VIP-LES/leos-sensor-pcb/LEOS-sensor.kicad_pcb

## KiCad design LEOS-sensor.kicad_pcb (2026-02-17)

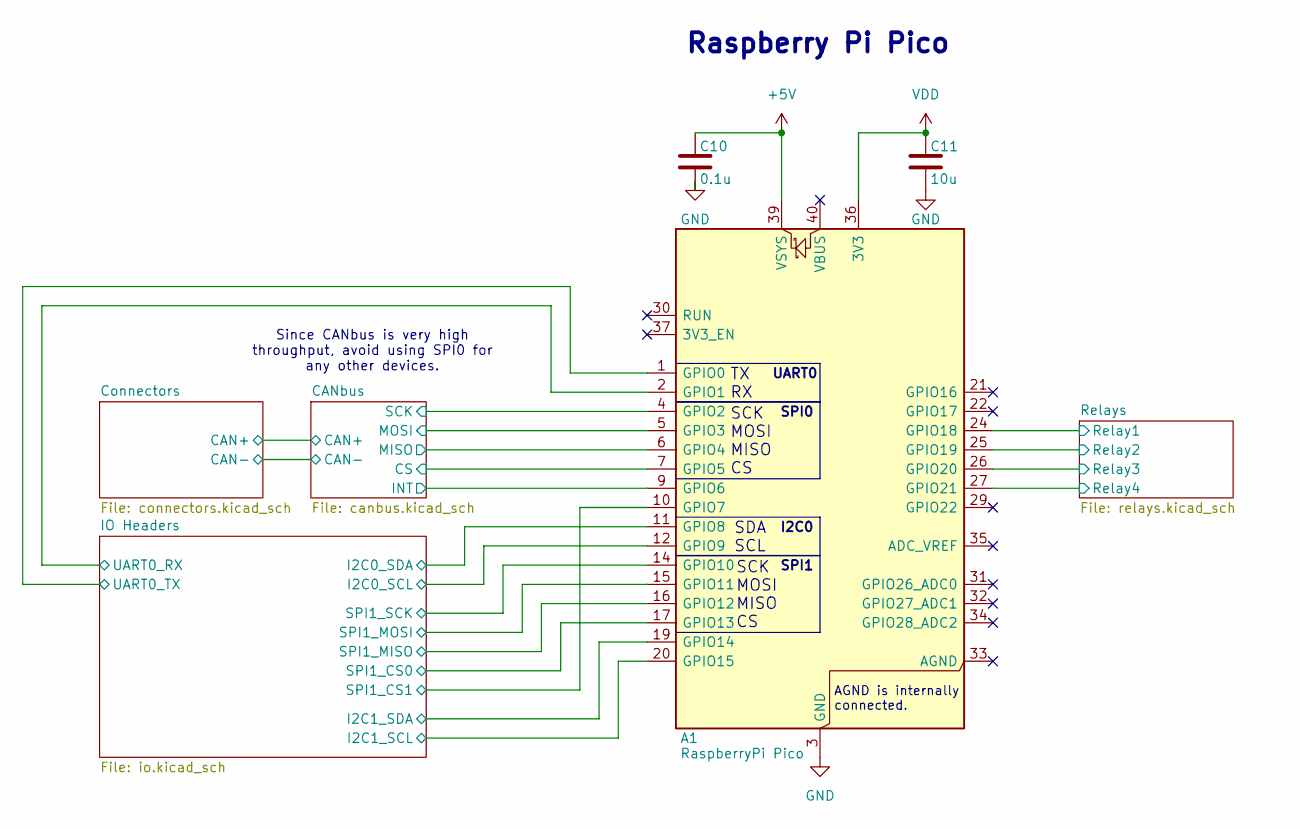
[picture p1: schematic LEOS-sensor.kicad_sch, LEOS Sensor Module]

Parts:
A1: RaspberryPi Pico; RaspberryPi_Pico_Common_THT; MPN PIM724; Digikey 1778-PIM724-ND
C10: 0.1u; C_0603_1608Metric; MPN CL10B104KB8NNNL; Digikey 1276-CL10B104KB8NNNLCT-ND
C11: 10u; C_0805_2012Metric; MPN CL21B106KOQNNNE; Digikey 1276-2872-1-ND

Connections:
+5V: A1.39 (VSYS), C10.1; also elsewhere on the board
/CANbus/CS: A1.7 (GPIO5); also elsewhere on the board
/CANbus/INT: A1.9 (GPIO6); also elsewhere on the board
/CANbus/MISO: A1.6 (GPIO4); also elsewhere on the board
/CANbus/MOSI: A1.5 (GPIO3); also elsewhere on the board
/CANbus/SCK: A1.4 (GPIO2); also elsewhere on the board
/IO Headers/I2C0_SCL: A1.12 (GPIO9); also elsewhere on the board
/IO Headers/I2C0_SDA: A1.11 (GPIO8); also elsewhere on the board
/IO Headers/I2C1_SCL: A1.20 (GPIO15); also elsewhere on the board
/IO Headers/I2C1_SDA: A1.19 (GPIO14); also elsewhere on the board
/IO Headers/SPI1_CS0: A1.17 (GPIO13); also elsewhere on the board
/IO Headers/SPI1_CS1: A1.10 (GPIO7); also elsewhere on the board
/IO Headers/SPI1_MISO: A1.16 (GPIO12); also elsewhere on the board
/IO Headers/SPI1_MOSI: A1.15 (GPIO11); also elsewhere on the board
/IO Headers/SPI1_SCK: A1.14 (GPIO10); also elsewhere on the board
/IO Headers/UART0_RX: A1.2 (GPIO1); also elsewhere on the board
/IO Headers/UART0_TX: A1.1 (GPIO0); also elsewhere on the board
/Relays/Relay1: A1.24 (GPIO18); also elsewhere on the board
/Relays/Relay2: A1.25 (GPIO19); also elsewhere on the board
/Relays/Relay3: A1.26 (GPIO20); also elsewhere on the board
/Relays/Relay4: A1.27 (GPIO21); also elsewhere on the board
GND: A1.3 (GND), A1.8 (GND), A1.13 (GND), A1.18 (GND), A1.23 (GND), A1.28 (GND), A1.38 (GND), C10.2, C11.2; also elsewhere on the board
VDD: A1.36 (3V3), C11.1; also elsewhere on the board

Notes on the sheet:
SPI1
Raspberry Pi Pico
SCK MOSI MISO CS
Since CANbus is very high throughput, avoid using SPI0 for any other devices.
SPI0
SDA SCL
TX RX
UART0
I2C0
AGND is internally connected.

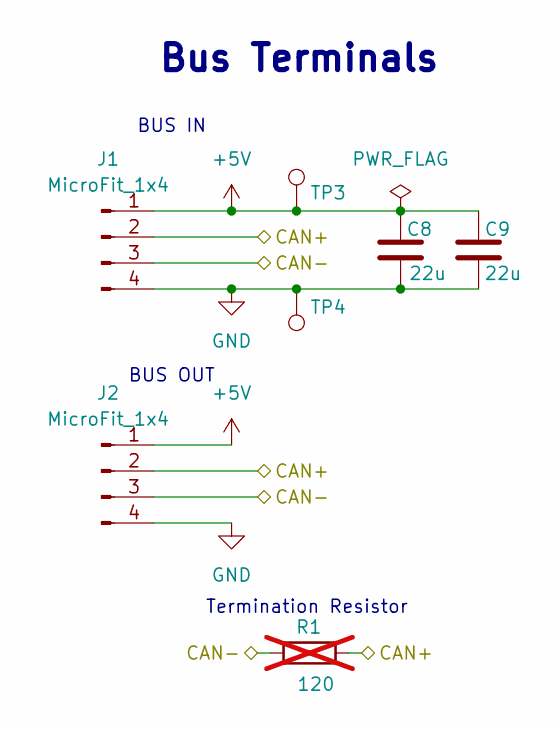
[picture p2: schematic connectors.kicad_sch, LEOS Connectors]

Parts:
C8, C9: 22u; C_0805_2012Metric; MPN CL21A226MAYNNNE; Digikey 1276-CL21A226MAYNNNECT-ND
J1, J2: MicroFit_1x4; Molex_MicroFit3.0_43650-0410_1x04_Horizontal; MPN 0436500409; Digikey WM1882CT-ND
R1: 120; R_Axial_DIN0207_L6.3mm_D2.5mm_P7.62mm_Horizontal; MPN CF14JT120R; Digikey CF14JT120RCT-ND; not fitted
TP3: 5V Test Point; TestPoint_Loop_D2.60mm_Drill0.9mm_Beaded; MPN 5000; Digikey 36-5000-ND
TP4: GND Test Point; TestPoint_Loop_D2.60mm_Drill0.9mm_Beaded; MPN 5001; Digikey 36-5001-ND

Connections:
+5V: C8.1, C9.1, J1.1, J2.1, TP3.1; also elsewhere on the board
/CANbus/CAN+: J1.2, J2.2, R1.2; also elsewhere on the board
/CANbus/CAN-: J1.3, J2.3, R1.1; also elsewhere on the board
GND: C8.2, C9.2, J1.4, J2.4, TP4.1; also elsewhere on the board

Notes on the sheet:
BUS OUT
Bus Terminals
BUS IN
Termination Resistor

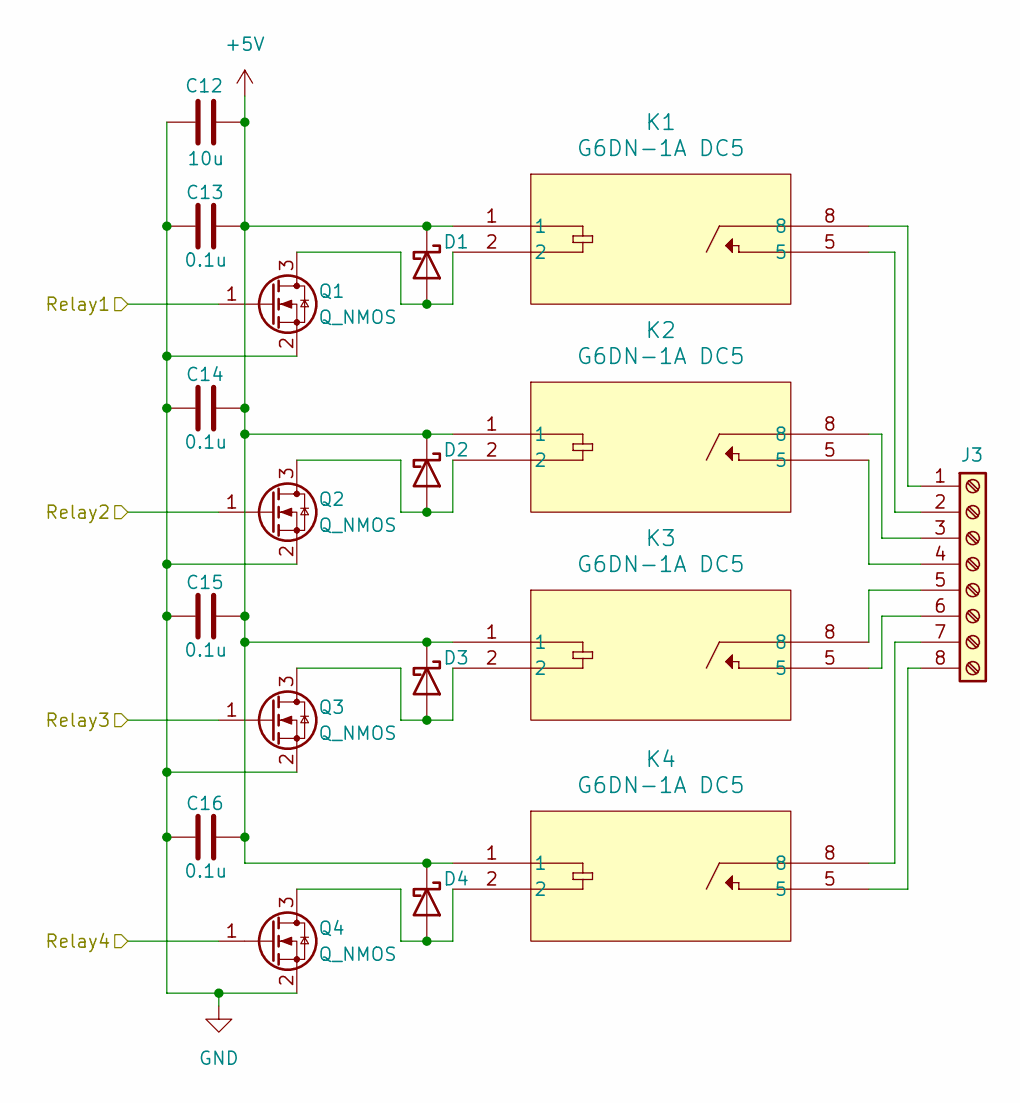
[picture p3: schematic relays.kicad_sch]

Parts:
C12: 10u; C_0805_2012Metric; MPN CL21B106KOQNNNE; LCSC C95841
C13, C14, C15, C16: 0.1u; C_0603_1608Metric; MPN CL10B104KB8NNNL; LCSC C913912
D1, D2, D3, D4: D_Schottky; D_SMA; MPN SS14; LCSC C83852
J3: Screw_Terminal_01x08; TerminalBlock_Phoenix_MKDS-1,5-8-5.08_1x08_P5.08mm_Horizont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; MPN 1715789; Digikey 277-1266-ND
K1, K2, K3, K4: G6DN-1A DC5; RELAY_G6DN-1A_OMR; MPN G6DN-1A DC5; Digikey 39-G6DN-1ADC5-ND
Q1, Q2, Q3, Q4: Q_NMOS; SOT-23; MPN IRLML0030TRPBF; LCSC C67272

Connections:
+5V: C12.2, C13.1, C14.1, C15.1, C16.1, D1.1 (K), D2.1 (K), D3.1 (K), D4.1 (K), K1.1, K2.1, K3.1, K4.1; also elsewhere on the board
/Relays/Relay1: Q1.1 (G); also elsewhere on the board
/Relays/Relay2: Q2.1 (G); also elsewhere on the board
/Relays/Relay3: Q3.1 (G); also elsewhere on the board
/Relays/Relay4: Q4.1 (G); also elsewhere on the board
GND: C12.1, C13.2, C14.2, C15.2, C16.2, Q1.2 (S), Q2.2 (S), Q3.2 (S), Q4.2 (S); also elsewhere on the board
unnamed: D1.2 (A), K1.2, Q1.3 (D)
unnamed: D2.2 (A), K2.2, Q2.3 (D)
unnamed: D3.2 (A), K3.2, Q3.3 (D)
unnamed: D4.2 (A), K4.2, Q4.3 (D)
unnamed: J3.1, K1.8
unnamed: J3.2, K1.5
unnamed: J3.3, K2.8
unnamed: J3.4, K2.5
unnamed: J3.5, K3.8
unnamed: J3.6, K3.5
unnamed: J3.7, K4.8
unnamed: J3.8, K4.5

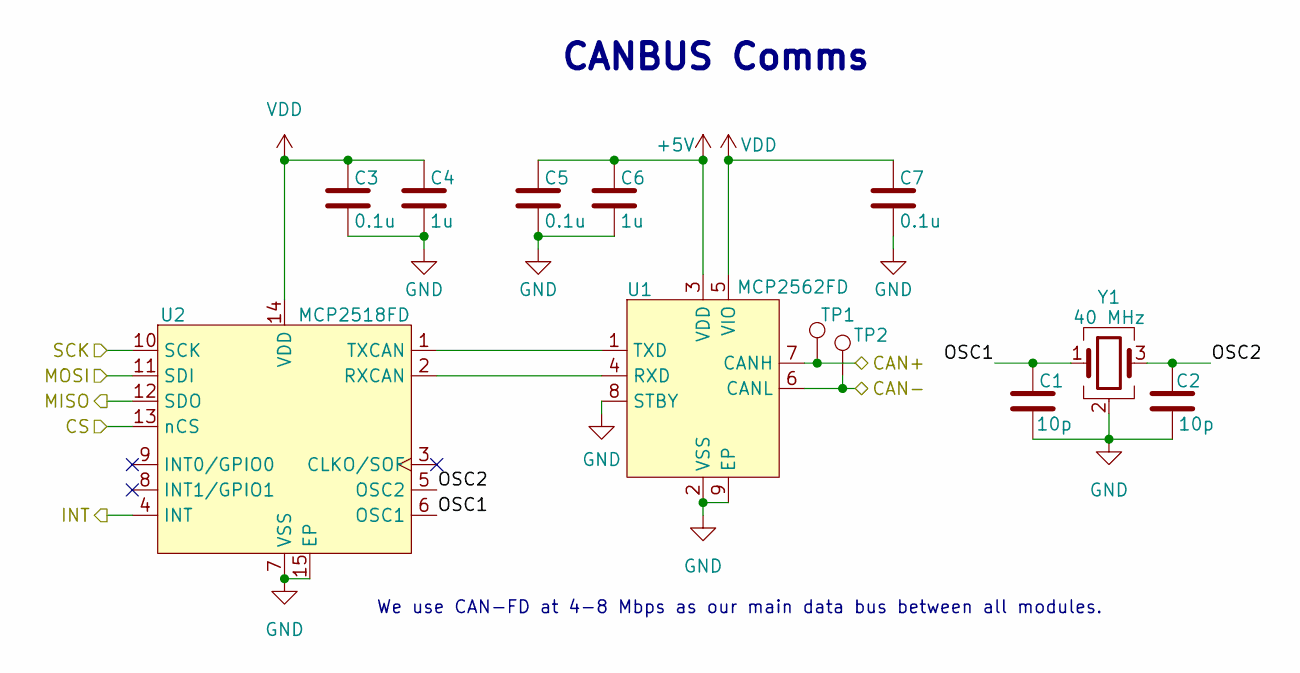
[picture p4: schematic canbus.kicad_sch, LEOS CANbus]

Parts:
C1, C2: 10p; C_0603_1608Metric; MPN CL10C100JB8NNNC; Digikey 1276-1027-1-ND
C3, C5, C7: 0.1u; C_0603_1608Metric; MPN CL10B104KB8NNNL; Digikey 1276-CL10B104KB8NNNLCT-ND
C4, C6: 1u; C_0603_1608Metric; MPN CL10B105KA8NNNC; Digikey 1276-1184-1-ND
TP1: CAN-H Test Point; TestPoint_Loop_D2.60mm_Drill0.9mm_Beaded; MPN 5004; Digikey 36-5004-ND
TP2: CAN-L Test Point; TestPoint_Loop_D2.60mm_Drill0.9mm_Beaded; MPN 5116; Digikey 36-5116-ND
U1: MCP2562FD; SOIC-8_3.9x4.9mm_P1.27mm; MPN MCP2562FDT-H/SN; LCSC C511335
U2: MCP2518FD; SOIC-14_3.9x8.7mm_P1.27mm; MPN MCP2518FDT-E/SL; LCSC C626758
Y1: 40 MHz; Crystal_SMD_2016-4Pin_2.0x1.6mm; MPN ECS-400-10-37B2-CKY-TR; Digikey 50-ECS-400-10-37B2-CKY-TRCT-ND

Connections:
+5V: C5.1, C6.1, U1.3 (VDD); also elsewhere on the board
/CANbus/CAN+: TP1.1, U1.7 (CANH); also elsewhere on the board
/CANbus/CAN-: TP2.1, U1.6 (CANL); also elsewhere on the board
/CANbus/CS: U2.13 (nCS); also elsewhere on the board
/CANbus/INT: U2.4 (INT); also elsewhere on the board
/CANbus/MISO: U2.12 (SDO); also elsewhere on the board
/CANbus/MOSI: U2.11 (SDI); also elsewhere on the board
/CANbus/OSC1: C1.2, U2.6 (OSC1), Y1.1
/CANbus/OSC2: C2.2, U2.5 (OSC2), Y1.3
/CANbus/SCK: U2.10 (SCK); also elsewhere on the board
GND: C1.1, C2.1, C3.2, C4.2, C5.2, C6.2, C7.2, U1.2 (VSS), U1.8 (STBY), U1.9 (EP), U2.7 (VSS), U2.15 (EP), Y1.2 (G), Y1.4 (G); also elsewhere on the board
unnamed: U1.4 (RXD), U2.2 (RXCAN)
unnamed: U1.1 (TXD), U2.1 (TXCAN)
VDD: C3.1, C4.1, C7.1, U1.5 (VIO), U2.14 (VDD); also elsewhere on the board

Notes on the sheet:
CANBUS Comms
We use CAN-FD at 4-8 Mbps as our main data bus between all modules.

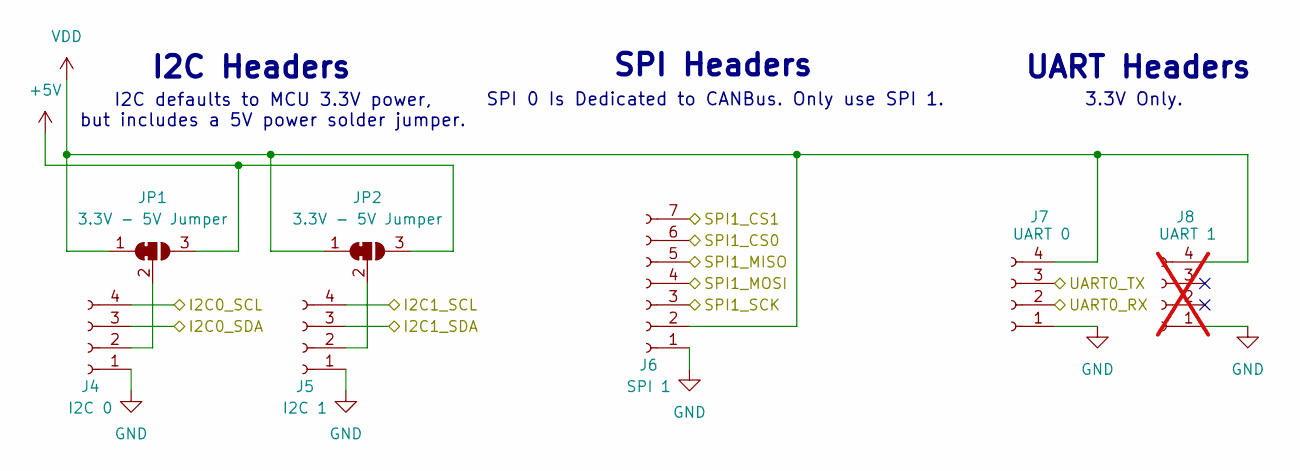
[picture p5: schematic io.kicad_sch, Sensor Board IO Headers]

Parts:
J4: I2C 0; JST_XH_S4B-XH-A_1x04_P2.50mm_Horizontal; MPN S4B-XH-A; Digikey 455-2243-ND
J5: I2C 1; JST_XH_S4B-XH-A_1x04_P2.50mm_Horizontal; MPN S4B-XH-A; Digikey 455-2243-ND
J6: SPI 1; JST_XH_S7B-XH-A_1x07_P2.50mm_Horizontal; MPN S7B-XH-A; Digikey 455-S7B-XH-A-ND
J7: UART 0; JST_XH_S4B-XH-A_1x04_P2.50mm_Horizontal; MPN S4B-XH-A; Digikey 455-2243-ND
J8: UART 1; JST_XH_S4B-XH-A_1x04_P2.50mm_Horizontal; MPN S4B-XH-A; Digikey 455-2243-ND; not fitted
JP1, JP2: 3.3V - 5V Jumper; SolderJumper-3_P1.3mm_Bridged12_RoundedPad1.0x1.5mm

Connections:
+5V: JP1.3 (B), JP2.3 (B); also elsewhere on the board
/IO Headers/I2C0_SCL: J4.4; also elsewhere on the board
/IO Headers/I2C0_SDA: J4.3; also elsewhere on the board
/IO Headers/I2C1_SCL: J5.4; also elsewhere on the board
/IO Headers/I2C1_SDA: J5.3; also elsewhere on the board
/IO Headers/SPI1_CS0: J6.6; also elsewhere on the board
/IO Headers/SPI1_CS1: J6.7; also elsewhere on the board
/IO Headers/SPI1_MISO: J6.5; also elsewhere on the board
/IO Headers/SPI1_MOSI: J6.4; also elsewhere on the board
/IO Headers/SPI1_SCK: J6.3; also elsewhere on the board
/IO Headers/UART0_RX: J7.2; also elsewhere on the board
/IO Headers/UART0_TX: J7.3; also elsewhere on the board
GND: J4.1, J5.1, J6.1, J7.1, J8.1; also elsewhere on the board
unnamed: J4.2, JP1.2 (C)
unnamed: J5.2, JP2.2 (C)
VDD: J6.2, J7.4, J8.4, JP1.1 (A), JP2.1 (A); also elsewhere on the board

Notes on the sheet:
3.3V Only.
SPI Headers
SPI 0 Is Dedicated to CANBus. Only use SPI 1.
UART Headers
I2C defaults to MCU 3.3V power, but includes a 5V power solder jumper.
I2C Headers

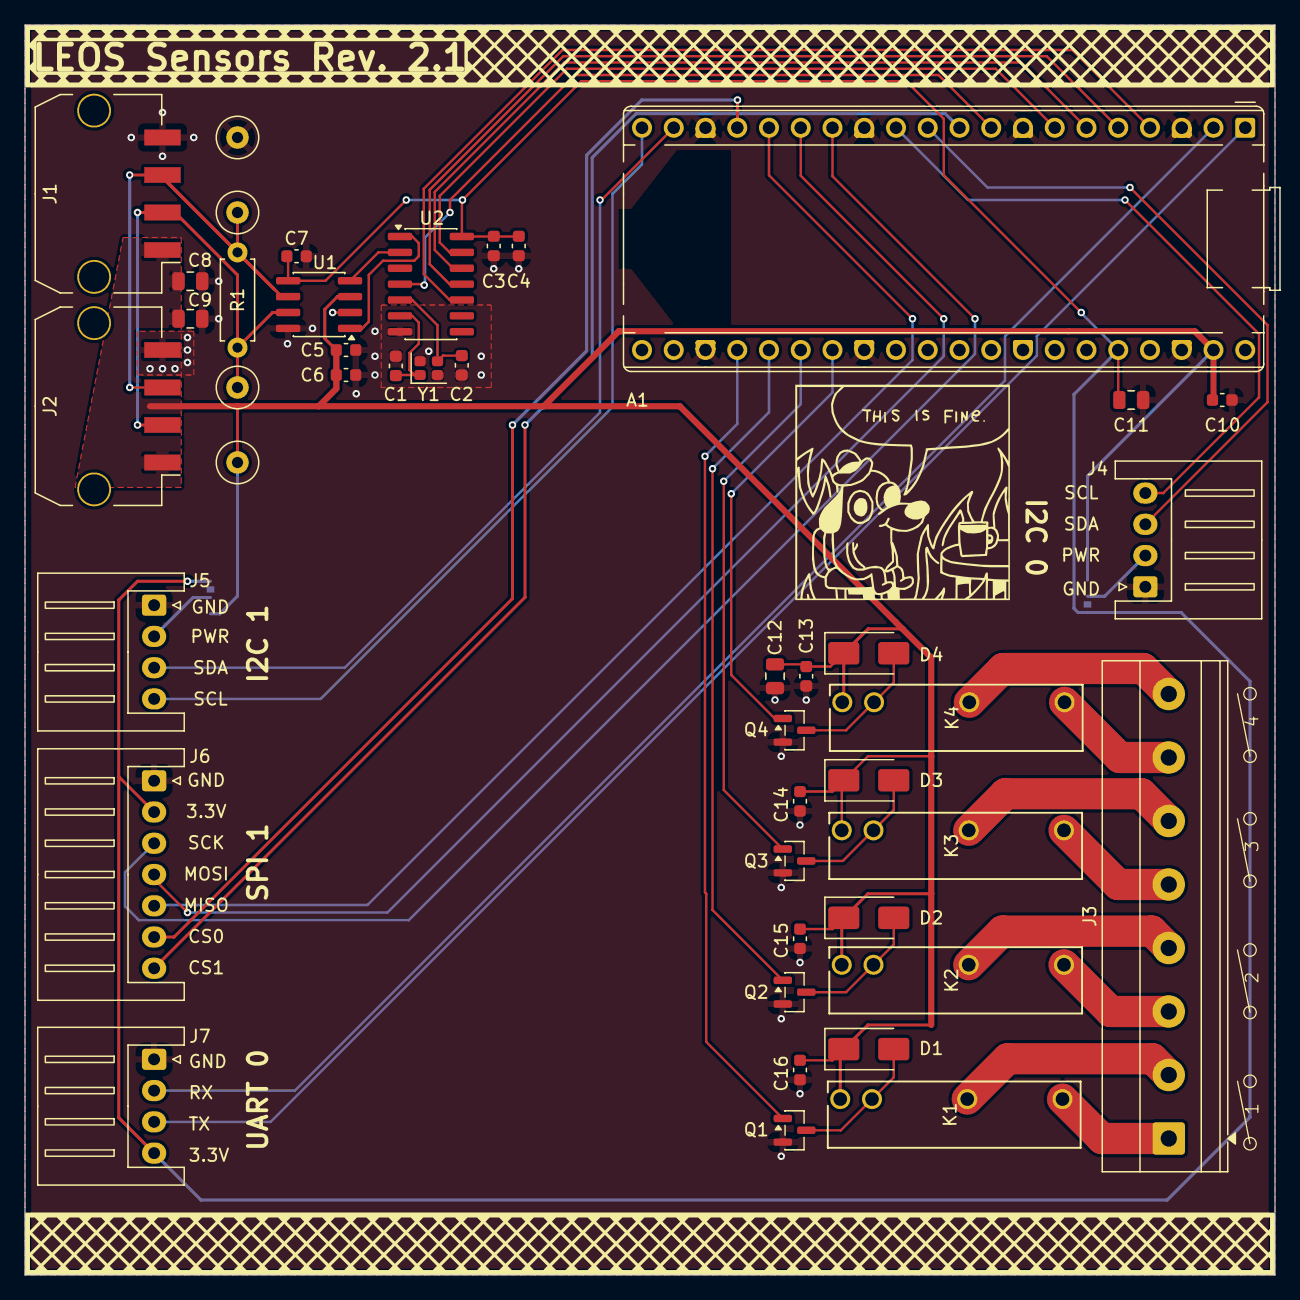
[picture p6: board LEOS-sensor.kicad_pcb from above]

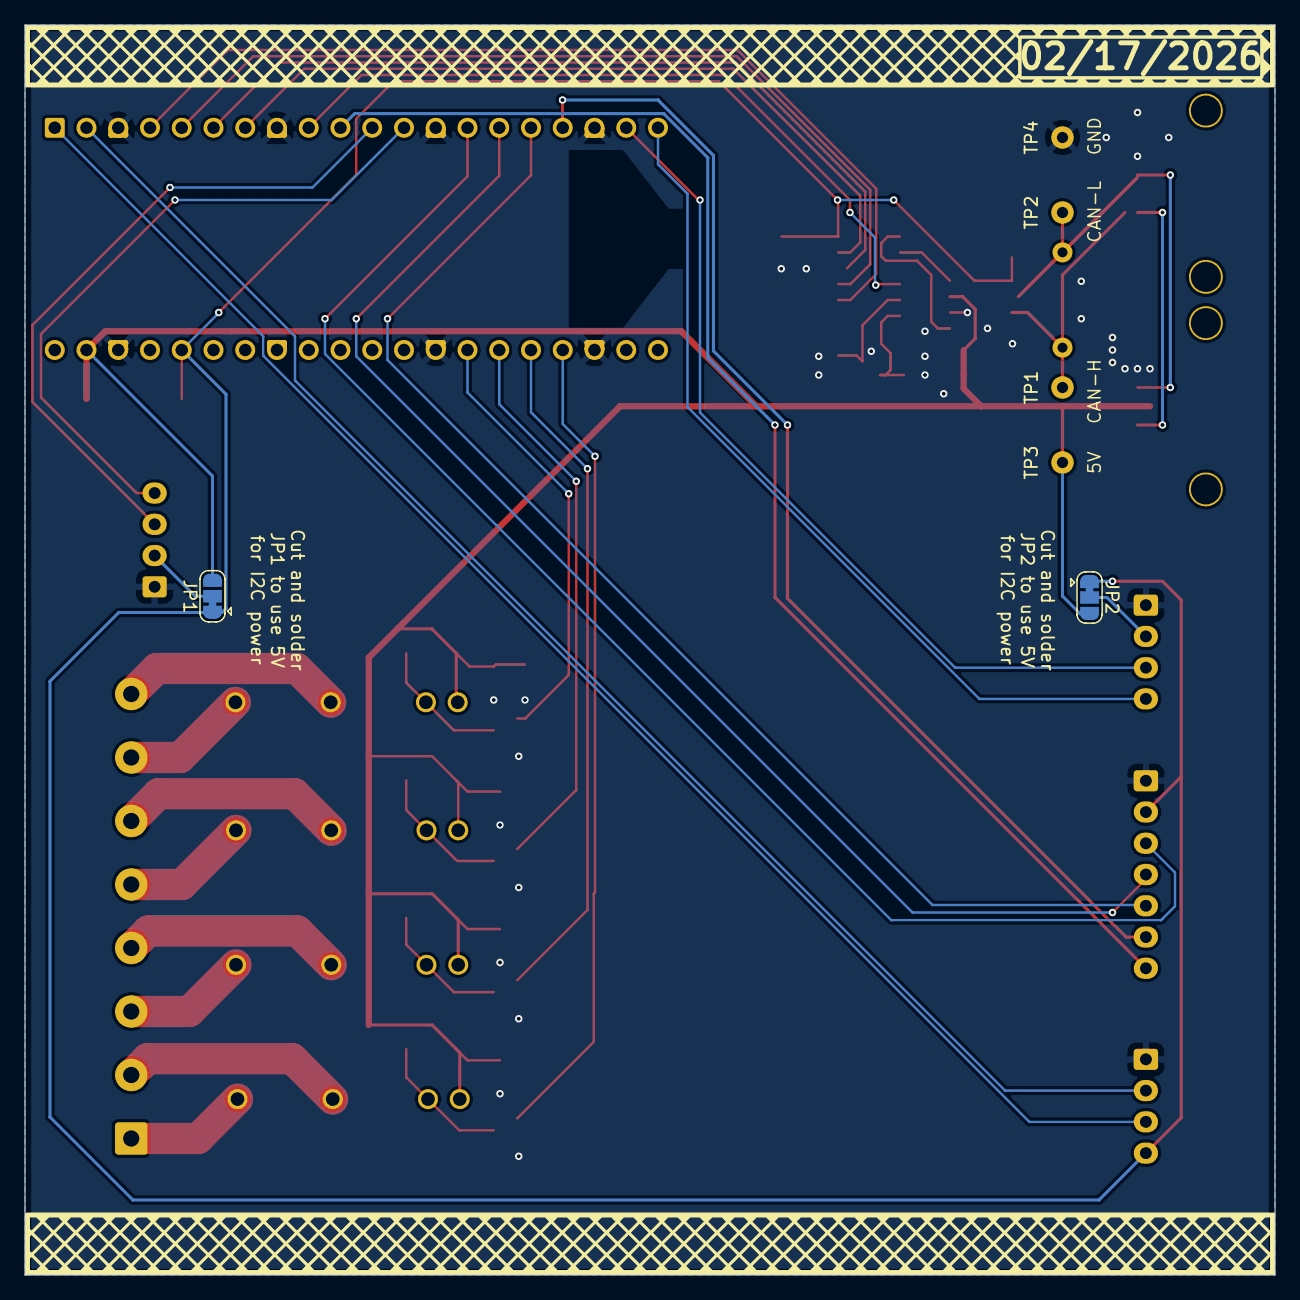
[picture p7: board LEOS-sensor.kicad_pcb from below]

Board: 2 copper layers, 100.0 x 100.0 mm, 46 parts (2 on the bottom side), 43 nets.
