VIP-LES/leos-sensor-pcb/(commit log)

2026-02-16 Updated from template, added graphics and JST-XH connectors
    [LEOS-sensor.kicad_pcb, LEOS-sensor.kicad_sch, LEOS-stack-template.kicad_pcb, canbus.kicad_sch, connectors.kicad_sch, io.kicad_sch, relays.kicad_sch]
2026-02-17 Add production date and up revision
    [LEOS-sensor.kicad_pcb, LEOS-sensor.kicad_sch, canbus.kicad_sch, relays.kicad_sch]
2026-02-17 Add .gitignore for KiCad and backup files
